Sparkl315/WheelchairDAS/README.md

# Project : WheelchairDAS

# **Driver Assistance System for Wheelchair**
Student Project in 2023 for UG BME Course

## Target
Develop an accurate & effective system while maintaining the cost

## System Overview

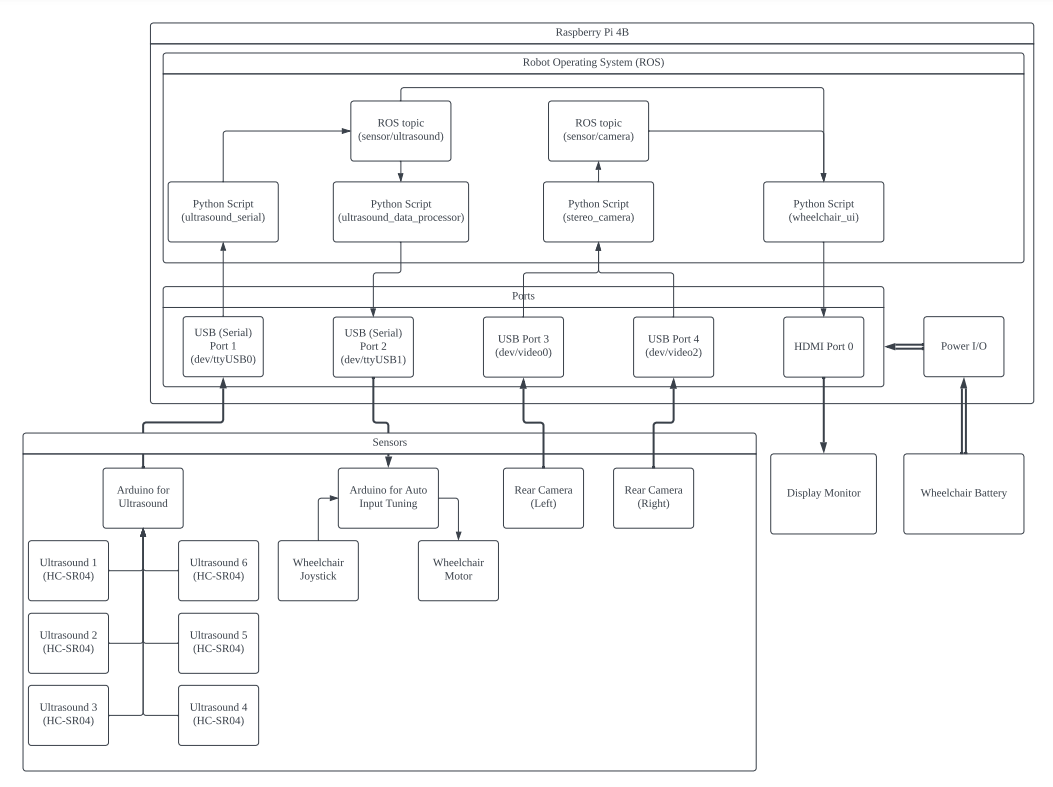
[picture p1: documents/diagrams/wheelchairDAS_overview.png]
System Overview


### Main Control Unit
 - **Raspberry Pi 4B**
 - Raspberry Pi OS & Robot Operating System (ROS (Noetic))
### Rear & Side Obstacle Detection
 - 6 Ultrasound (HC-SR04) for Side Obstable Detection
 - Stereo Camera for Rear Obstacle Detection
### Auto Input Tuning
 - Arduino connected to Joystick input for interception and Manipulation
 - Able to be turned On or Off with preference
### Graphical User Interface
 - Indicators for obstacle direction & distances
 - Rear Camera View Display

## Technical Details
### Rear & Side Obstacle Detection
**Side Obstacle Detection**

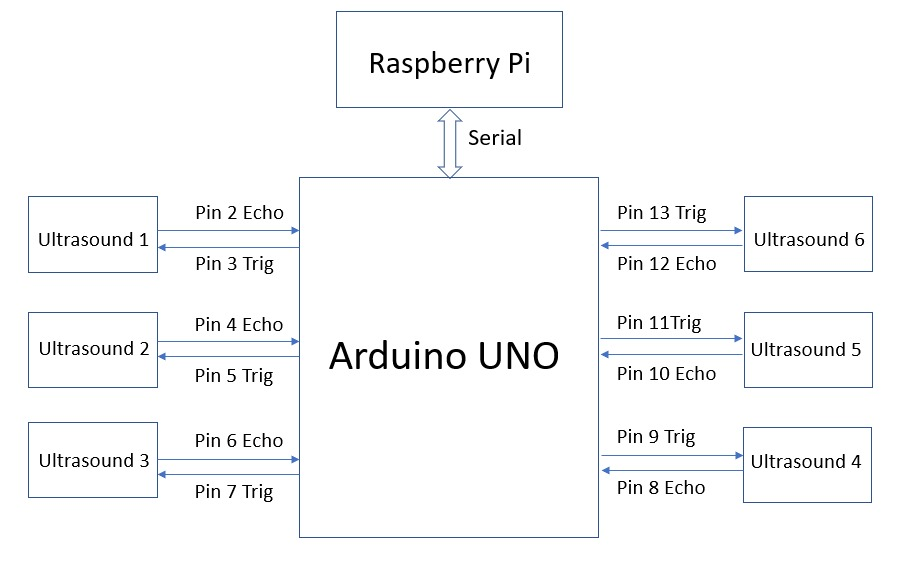
[picture p2: documents/diagrams/Obstacle_Detection/Block diagram arduino ultrasound.jpeg]
Block Diagram


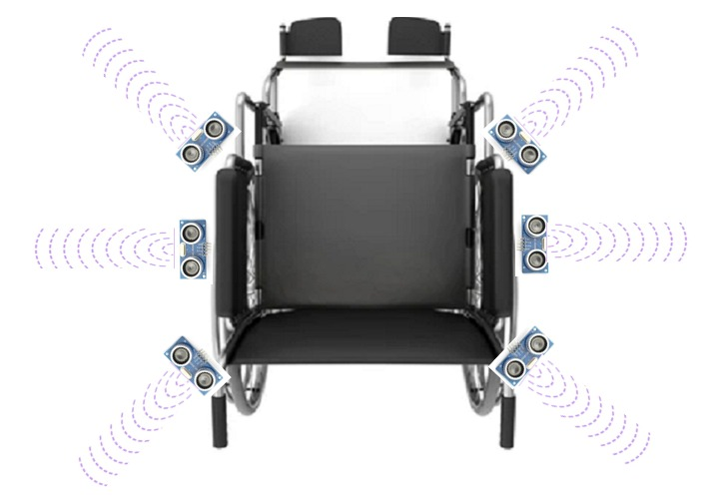
[picture p3: documents/diagrams/Obstacle_Detection/Side_obstacle_detection_placement.jpeg]
Ulrasound Placement


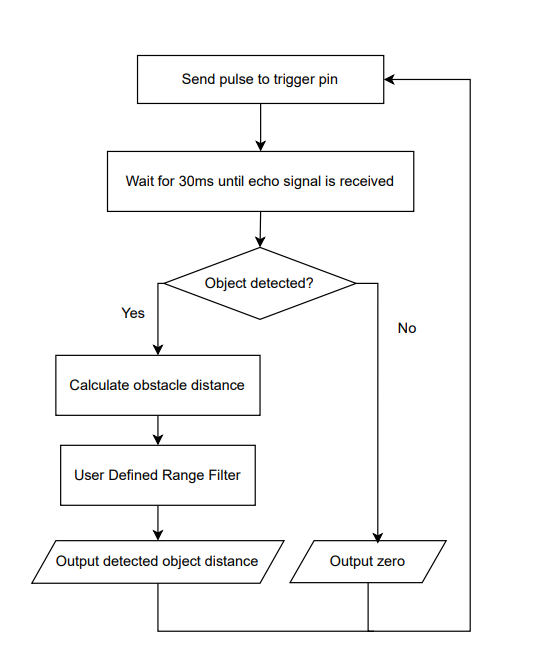
[picture p4: documents/diagrams/Obstacle_Detection/ultrasound detection flowchart.png]
Flowchart


**Rear Obstacle Detection**

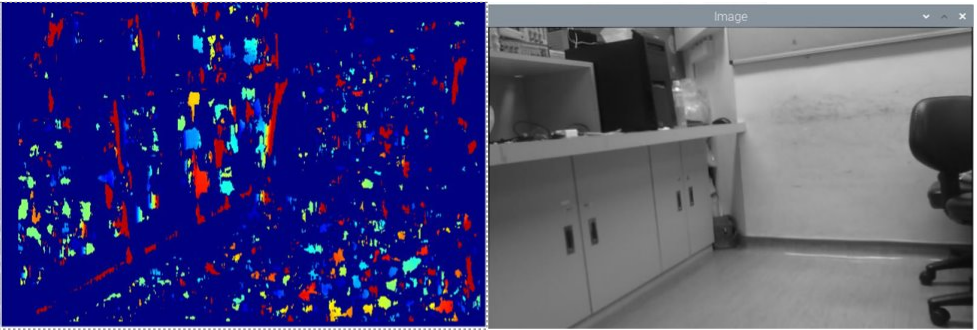
[picture p5: documents/diagrams/Obstacle_Detection/rear_camera.png]
Diagram


 - Image View from rear USB camera
 - Depth Sensing using OpenCV

### Auto Input Tuning

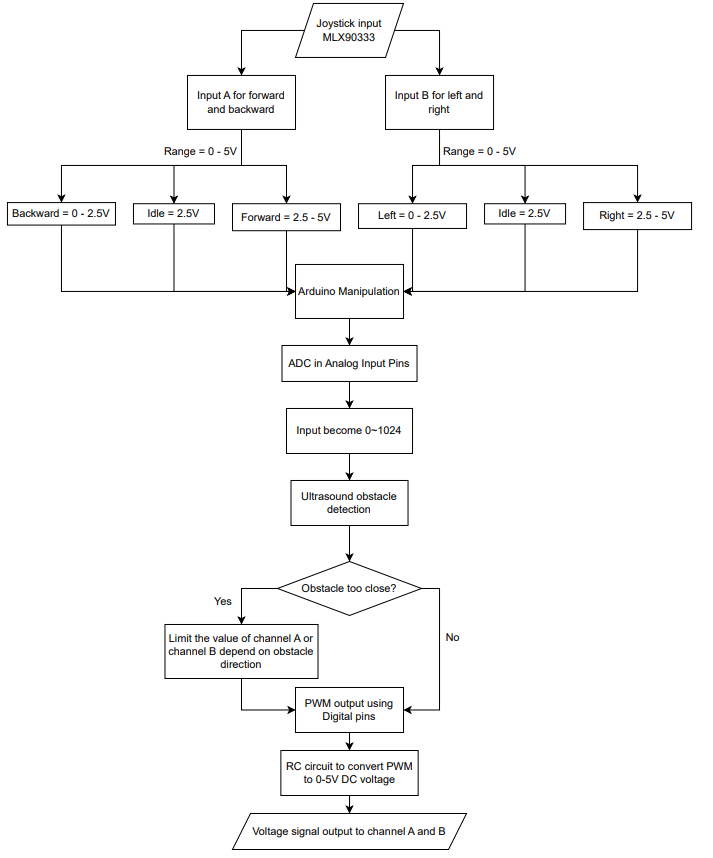
[picture p6: documents/diagrams/Auto_Input_Tuning/Auto_input_tuning_flowchart.png]
Flowchart


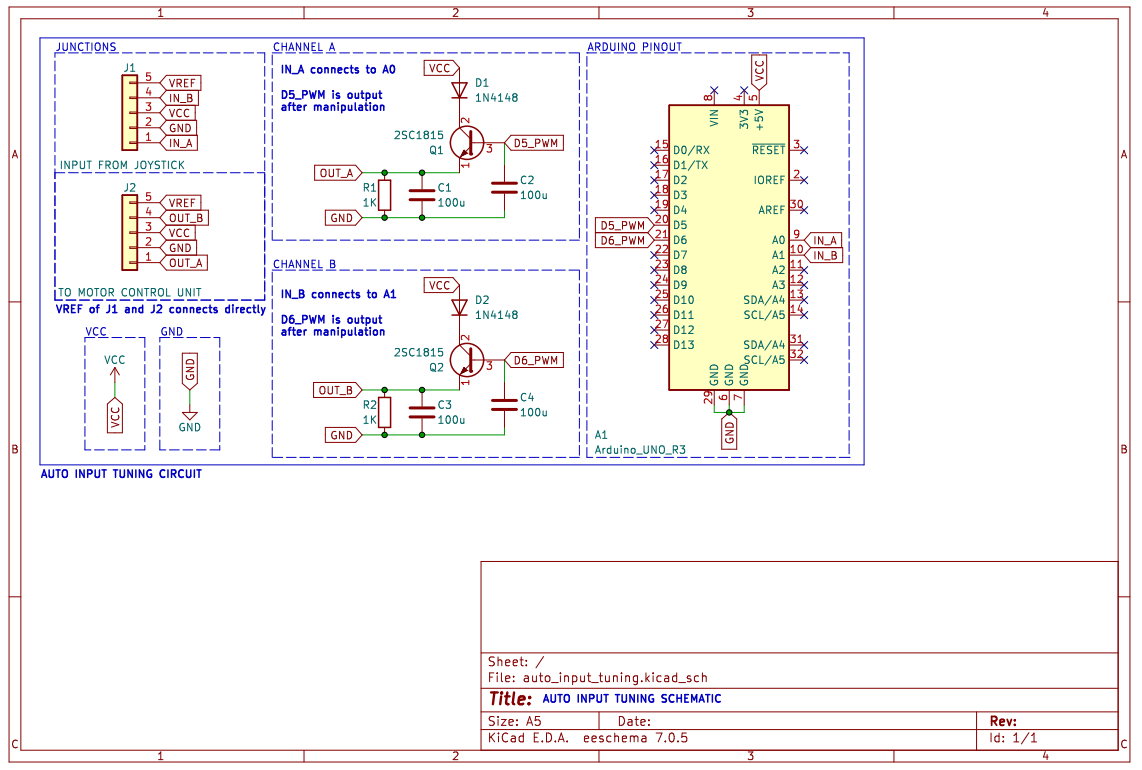
[picture p7: documents/schematics/auto_input_tuning_schematic.png]
Circuit Schematic


> **EXPLANATION**
> - Joystick Input (MLX90333)
>   - DC Voltage Output Range 0~5V
>   - Output Channel A : Vertical Direction
>   - Output Channel B : Horizontal Direction
>   - Output 2.5V when idle
> - Arduino Manipulation
>   - Receive Joystick Voltage from Channel A and B (Input become 0~1024 after going through ADC in Analog Input Pins)
>   - Reading from ROS topic of Rear Obstacles
>   - If obstacle are too close, prevent the wheelchair from moving toward that direction by a limiter
>   - PWM Output using Digital pins supporting PWM (0~255)
> - Simulate DC Voltage Output
>   - Convert the duty cycle of Arduino PWM output to DC voltage with RC circuit
> - Pass the manipulated Voltage Signal back to Channel A and Channel B

### Graphical User Interface

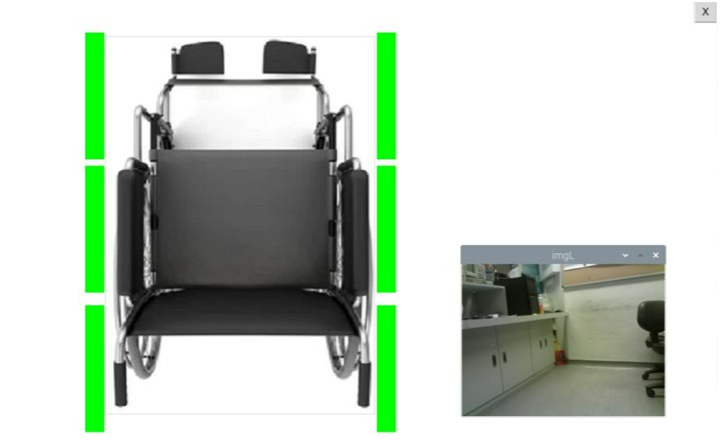
[picture p8: documents/diagrams/WheelchairUI/user_interface.png]
User Interface


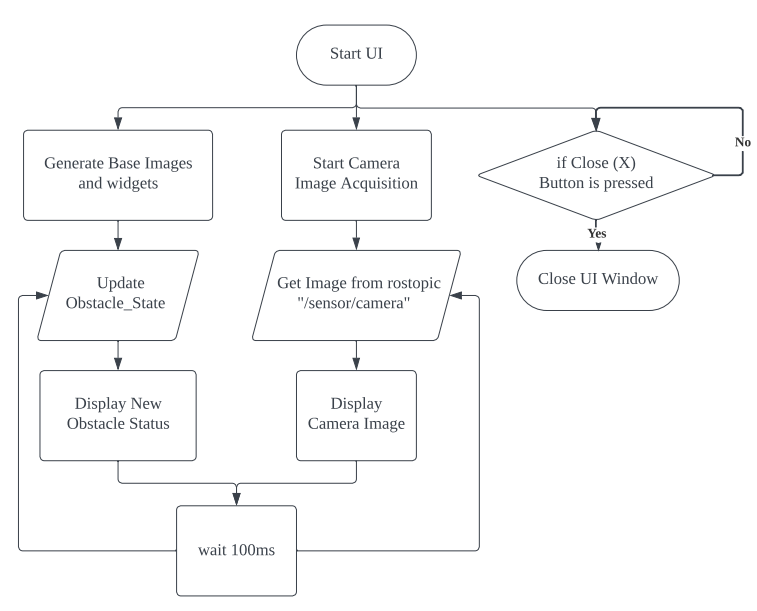
[picture p9: documents/diagrams/WheelchairUI/wheelchair_ui_flowchart.png]
Flowchart
