Sparkl315/WheelchairDAS/documents/diagrams/Obstacle_Detection/ultrasound detection flowchart.pdf

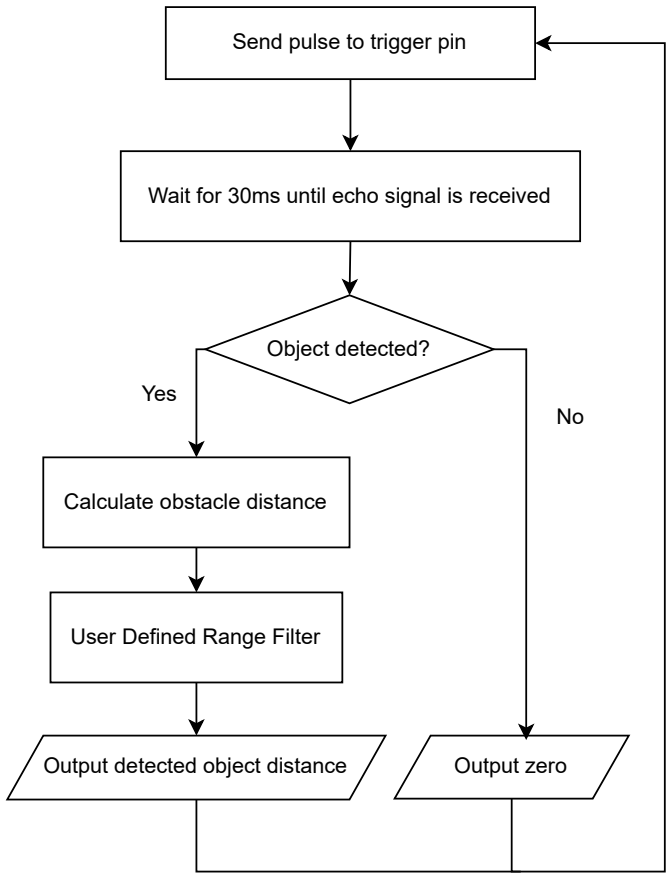
[picture p10: figure]
Send pulse to trigger pin; User Defined Range Filter; Calculate obstacle distance; Output detected object distance; Output zero; Object detected?; Yes

Wait for 30ms until echo signal is received
