Sparkl315/WheelchairDAS/src/wheelchairUI/images/left down green.png

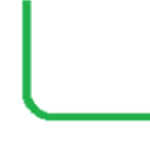
src/wheelchairUI/images/left down green.png
