Sparkl315/WheelchairDAS/src/wheelchairUI/images/left down red.png

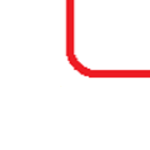
src/wheelchairUI/images/left down red.png
