Sparkl315/WheelchairDAS/src/wheelchairUI/images/left down yellow.png

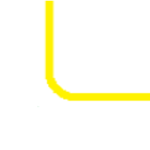
src/wheelchairUI/images/left down yellow.png
