Sparkl315/WheelchairDAS/src/wheelchairUI/images/left middle green.png

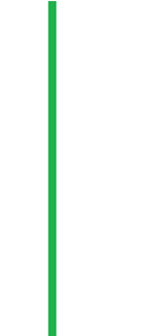
src/wheelchairUI/images/left middle green.png
