Sparkl315/WheelchairDAS/src/wheelchairUI/images/left middle red.png

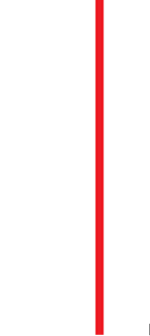
src/wheelchairUI/images/left middle red.png
