Sparkl315/WheelchairDAS/src/wheelchairUI/images/left middle yellow.png

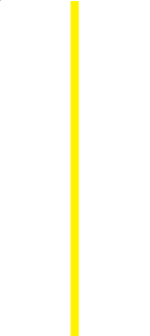
src/wheelchairUI/images/left middle yellow.png
