Sparkl315/WheelchairDAS/src/wheelchairUI/images/left up green.png

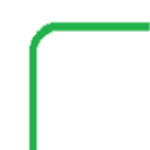
src/wheelchairUI/images/left up green.png
