Sparkl315/WheelchairDAS/src/wheelchairUI/images/left up red.png

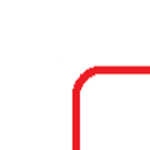
src/wheelchairUI/images/left up red.png
