Sparkl315/WheelchairDAS/src/wheelchairUI/images/left up yellow.png

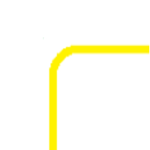
src/wheelchairUI/images/left up yellow.png
