Sparkl315/WheelchairDAS/src/wheelchairUI/images/rear mirror.jpg

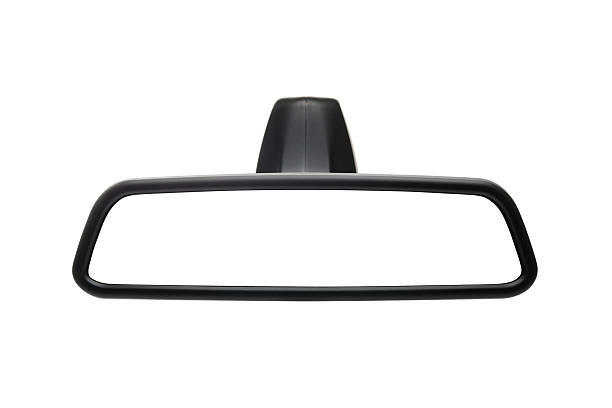
src/wheelchairUI/images/rear mirror.jpg
