Sparkl315/WheelchairDAS/src/wheelchairUI/images/right down green.png

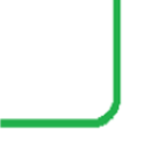
src/wheelchairUI/images/right down green.png
