Sparkl315/WheelchairDAS/src/wheelchairUI/images/right down red.png

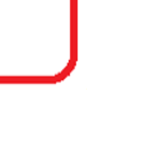
src/wheelchairUI/images/right down red.png
