Sparkl315/WheelchairDAS/src/wheelchairUI/images/right down yellow.png

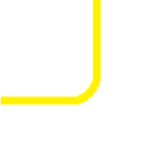
src/wheelchairUI/images/right down yellow.png
