Sparkl315/WheelchairDAS/src/wheelchairUI/images/right up green.png

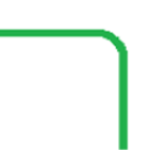
src/wheelchairUI/images/right up green.png
