Sparkl315/WheelchairDAS/src/wheelchairUI/images/right up red.png

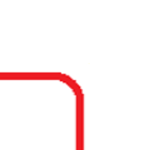
src/wheelchairUI/images/right up red.png
