Sparkl315/WheelchairDAS/src/wheelchairUI/images/right up yellow.png

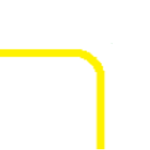
src/wheelchairUI/images/right up yellow.png
