Sparkl315/WheelchairDAS/src/wheelchairUI/images/wheelchair.png

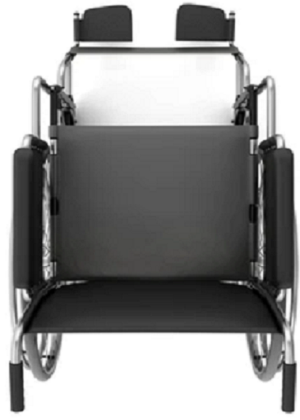
src/wheelchairUI/images/wheelchair.png
