Sparkl315/WheelchairDAS/documents/diagrams/wheelchairDAS_overview.pdf

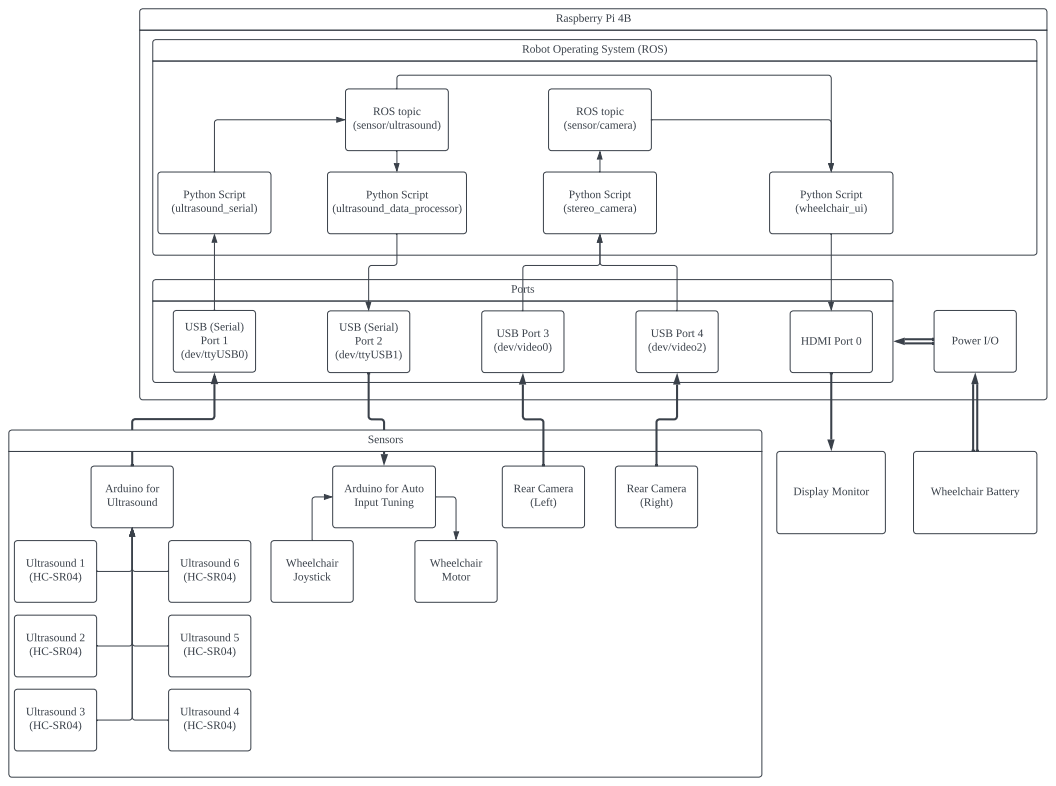
[picture p28: page 1]
Ports; Ultrasound 1 (HC-SR04); Ultrasound 2 (HC-SR04); Ultrasound 3 (HC-SR04); Ultrasound 4 (HC-SR04); Ultrasound 5 (HC-SR04); Ultrasound 6 (HC-SR04); Arduino for Ultrasound; Wheelchair Joystick; Rear Camera (Left); Rear Camera (Right); Wheelchair Motor; USB (Serial) Port 1 (dev/ttyUSB0); USB (Serial) Port 2 (dev/ttyUSB1); USB Port 3 (dev/video0); USB Port 4 (dev/video2); Sensors; Raspberry Pi 4B; Wheelchair Battery; HDMI Port 0; Display Monitor; Power I/O; ROStopic (sensor/ultrasound)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

Robot Operating System (ROS)

Arduino for Auto
Input Tuning
