Sparkl315/WheelchairDAS/documents/diagrams/Auto_Input_Tuning/Auto_input_tuning_flowchart.pdf

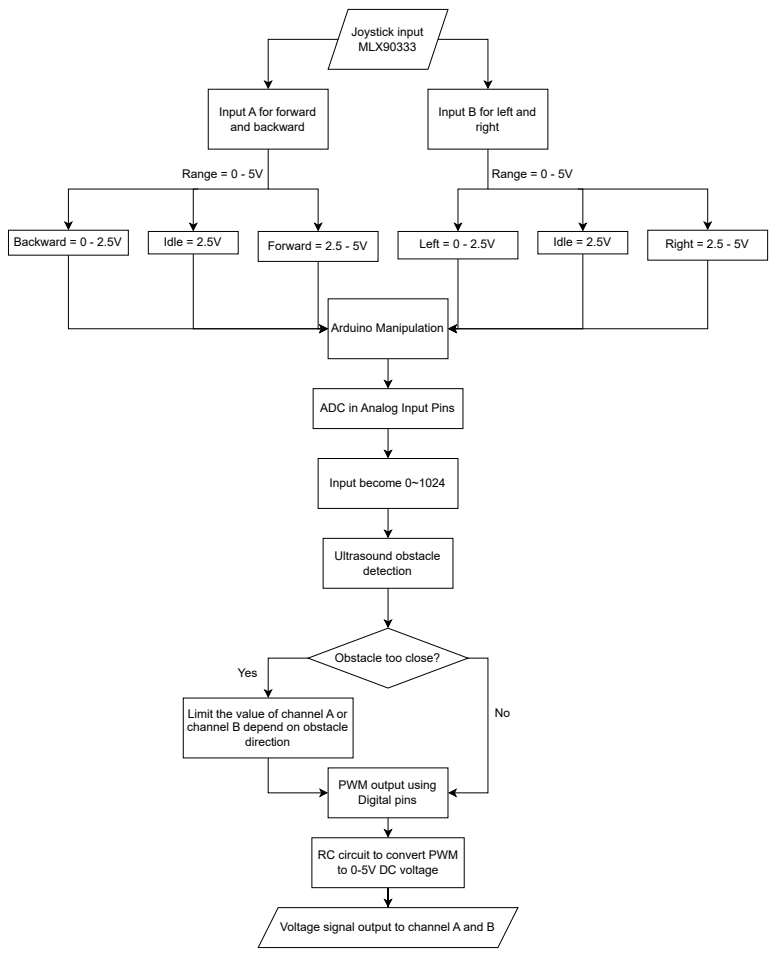
[picture p29: page 1]
Joystick input MLX90333; Arduino Manipulation; Range = 0 - 5V; Idle = 2.5V; Forward = 2.5 - 5V Backward = 0 - 2.5V; Left = 0 - 2.5V; Right = 2.5 - 5V; Input become 0~1024; Ultrasound obstacle detection; direction; Yes

Input A for forward
and backward

Input B for left and
right

ADC in Analog Input Pins

Obstacle too close?

Limit the value of channel A or
channel B depend on obstacle

PWM output using
Digital pins

RC circuit to convert PWM
to 0-5V DC voltage

Voltage signal output to channel A and B
