Sparkl315/WheelchairDAS/documents/diagrams/WheelchairUI/wheelchair_ui_flowchart.pdf

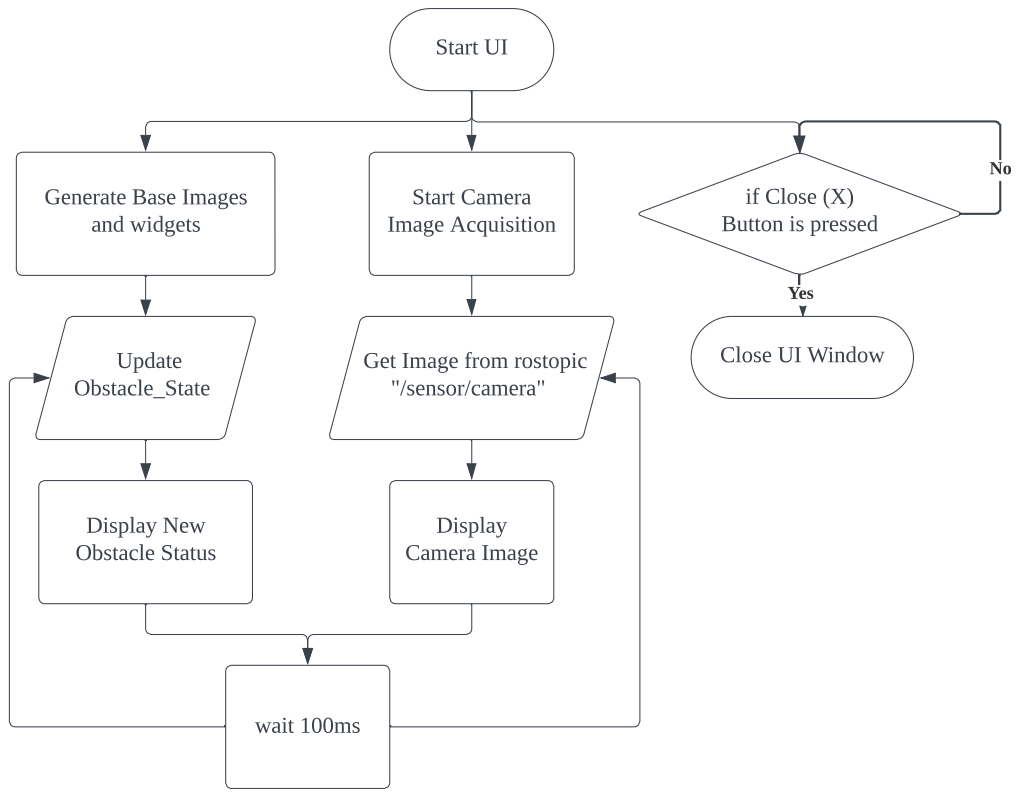
[picture p30: page 1]
Start UI; GenerateBaseImages and widgets; Update Obstacle_State; Display New ObstacleStatus; Start Camera ImageAcquisition; CloseUI Window; if Close(X) Button ispressed; Display CameraImage; Yes; wait 100ms

Get Imagefrom rostopic
"/sensor/camera"
