Sparkl315/WheelchairDAS/documents/schematics/auto_input_tuning_schematic.pdf

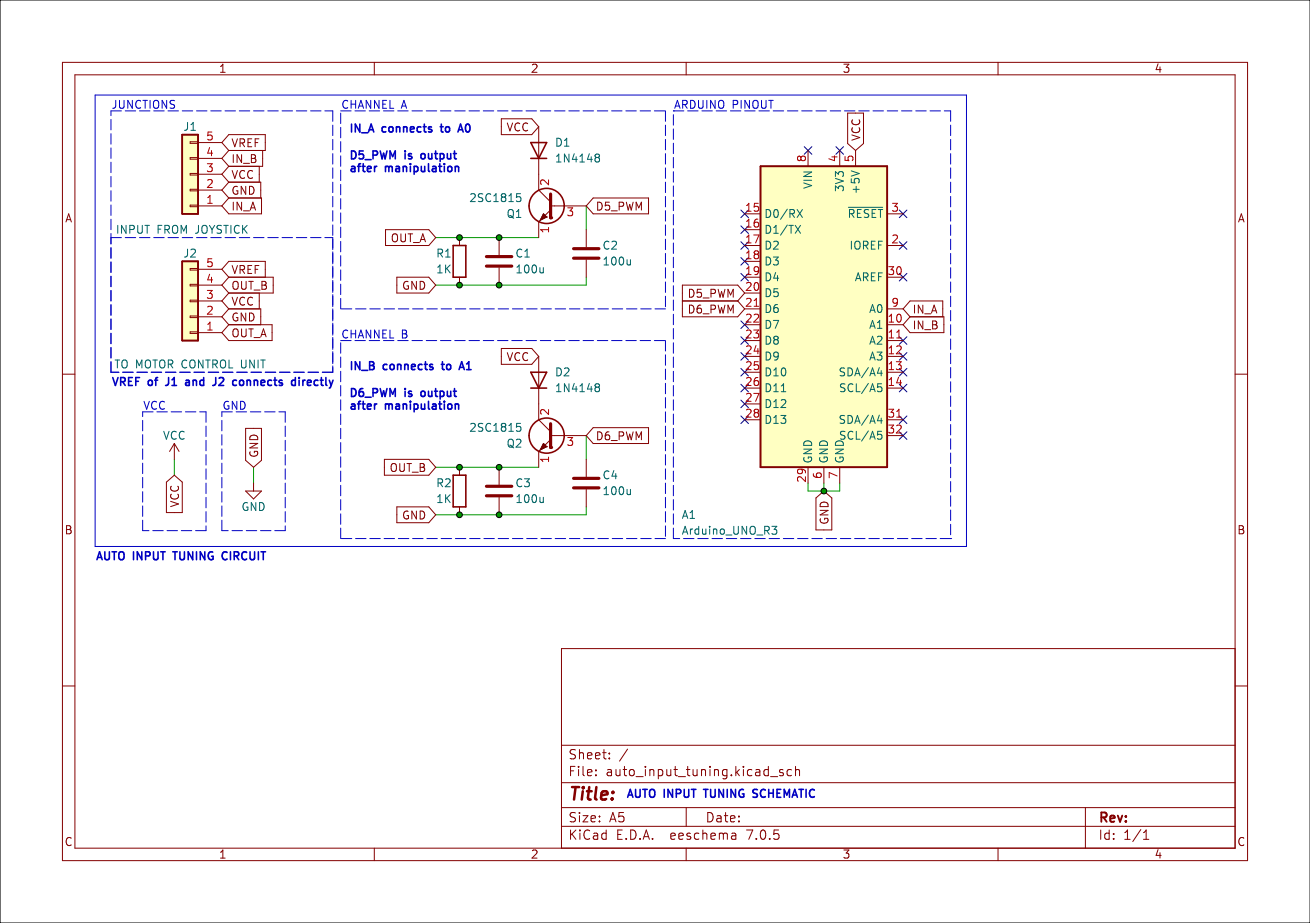
[picture p31: page 1]
