Sparkl315/WheelchairDAS/(commit log)

2023-06-23 Update 23/6 wheelchair_ui.py
2023-06-28 28/6 Update wheelchair_ui.py
2023-06-30 30/6 Update wheelchair_ui.py
2023-07-03 Update ultrasound.ino to 6 sonar setup
2023-07-04 add schematics document
2023-07-05 Update joy2motor_v4.ino
    Added framework for Obstacle Existence Reactions
